sublimatedware/Drone-Detection-Robot-UoG-Captstone-2025-Legacy-/v8 test dataset/labels.jpg

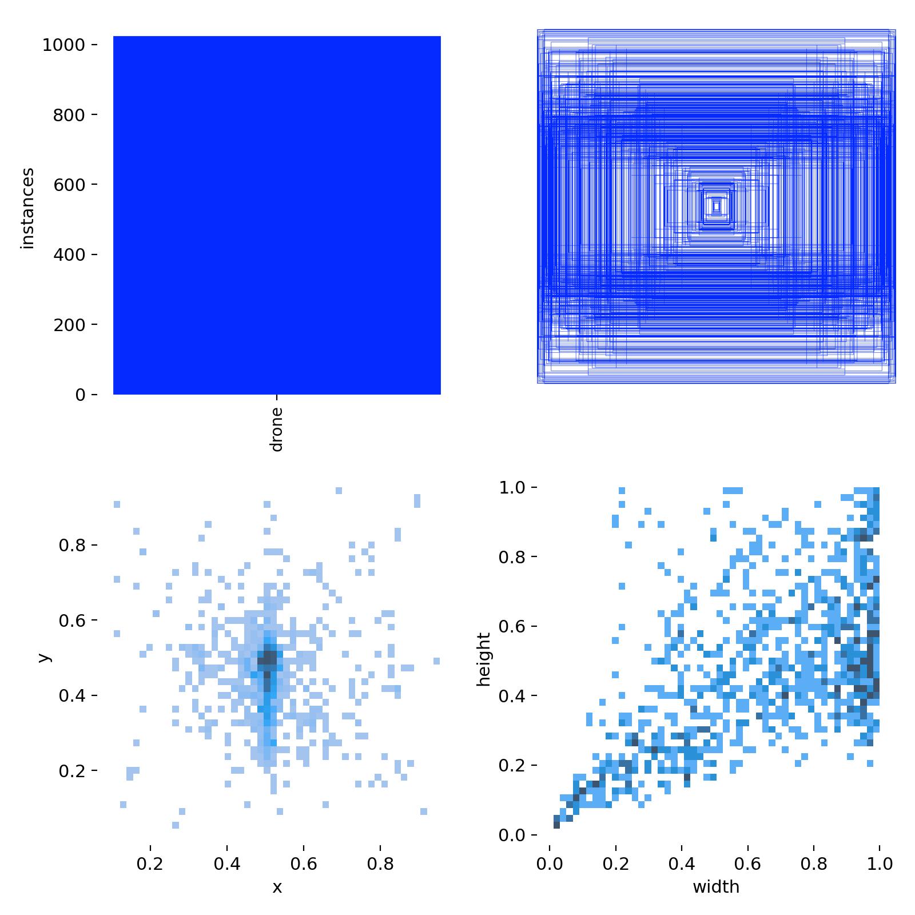
v8 test dataset/labels.jpg
