sublimatedware/Drone-Detection-Robot-UoG-Captstone-2025-Legacy-/README.md

# Drone-Detection-Robot-UoG-Captstone-2025-Legacy-
A global shutter camera attached to a 2 axis gimbal which automatically detects and tracks quadcoter style drones using YOLO computer vision
