sublimatedware/Drone-Detection-Robot-UoG-Captstone-2025-Legacy-/ENGG41x0_Drone_Tracker_Poster.pdf

## Jake Lamoureux | Laura Cao | Dominik Hoang | Kevin Pham

# Advanced Drone Tracking Camera System

Winter 2025

## Problem Statement

## Results

Confusion Matrix

## Objective

## Motor Controller

### - TB6600 Stepper

### Motor Controller

## 120 FPS Camera

### - Econ Systems

### See3CAM_24CUG

## 360°Camera Mount

### - Two-stepper motor arm

### design for precise Y- and

Z-axis movement.

## Microcontroller

### - Arduino Uno

## Faculty Advisor:

Hussein Abdullah, PhD, P.Eng.

## Background

As drones become more widely used in homes and businesses, the need for effective tracking solutions that address privacy,

### real-time processing, and environmental adaptability becomes

increasingly important. Many solutions are costly, inefficient,

### and fail to meet regulatory and safety standards. There is a

### clear need for an affordable, efficient, and privacy-conscious drone tracking system that integrates seamlessly into modern

security frameworks while ensuring safety and compliance.

- Develop an affordable drone tracking system that provides real-time, accurate tracking while ensuring privacy for consumers and businesses.
- Integrate responsive servo motor control for smooth, precise tracking and reduced safety risks in dynamic environments.
- Optimize for power efficiency to lower operational costs and extend runtime, making the solution accessible to both commercial and household users.
- Design a scalable, adaptable system functional in various environments and affordable drone models.
- Drone use has grown rapidly, especially in consumer markets for home security and personal use.
- As drones become more
widespread, privacy, safety, and effective tracking are growing concerns.
- While tracking systems have improved in accuracy, many still face challenges with real-time processing and adaptability.
- Existing solutions are often expensive and lack power
efficiency for extended use.

F1-Confidence Curve

- 137 Correct drone
detections (True
Positives)
- 29 Background
misclassified as drones
(False Positives)
- 14 Missed drones (False
Negatives)
- F1 is a combination of Recall and Precision
- Max. Performance is at
around 60% Confidence
- Higher = Strict (fewer
detections & false alarms)
- Lower = Lenient (more
detections & false positives)

## Design Solution

- The system integrates object detection technology for real-time tracking using visual processing.
- YOLOv8 was implemented to ensure high accuracy in dynamic environments.
- The design was tested under various lighting and movement conditions, balancing speed and accuracy.
- Servo motors control camera positioning, enabling smooth, responsive tracking with low latency.
- Feedback from drone operators and object detection experts refined the system’s performance and reliability.
- The final design achieves accurate and fast tracking while maintaining regulatory compliance.

## Sample Output

137 29

14

## Sample Dataset
