sublimatedware/Drone-Detection-Robot-UoG-Captstone-2025-Legacy-/Photos/20250327_173003.jpg

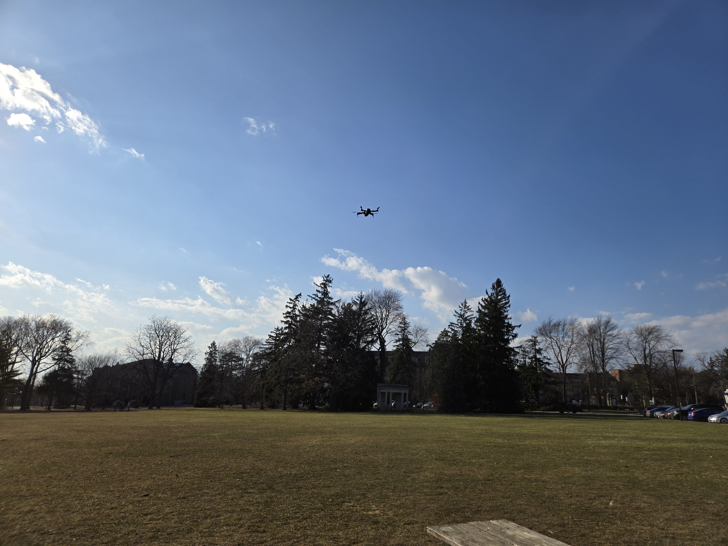
Photos/20250327_173003.jpg
