sublimatedware/Drone-Detection-Robot-UoG-Captstone-2025-Legacy-/Photos/20250327_173009.jpg

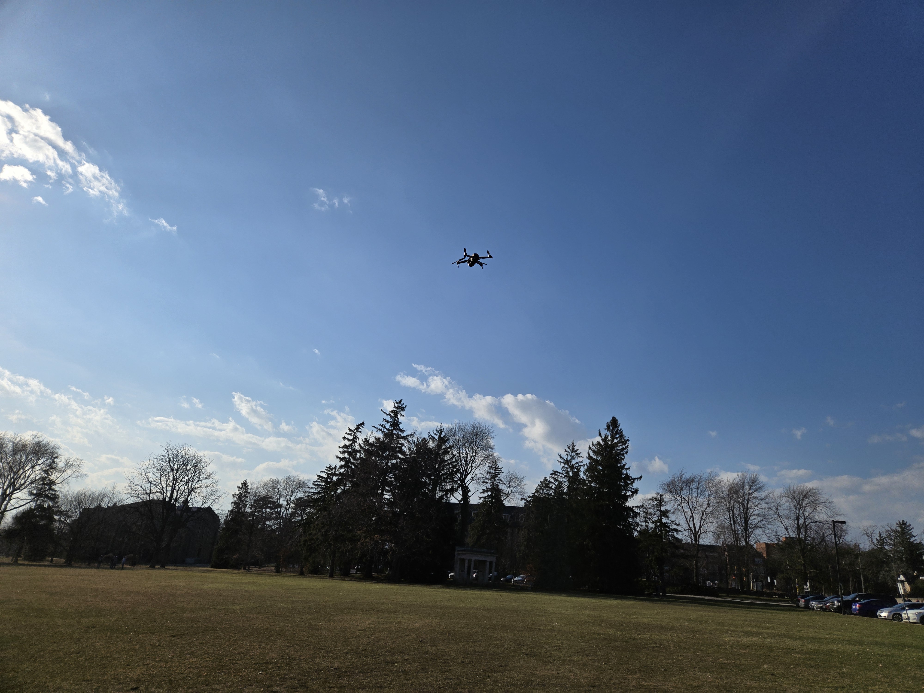
Photos/20250327_173009.jpg
