sublimatedware/Drone-Detection-Robot-UoG-Captstone-2025-Legacy-/hardware/drone robot bracket.SLDPRT

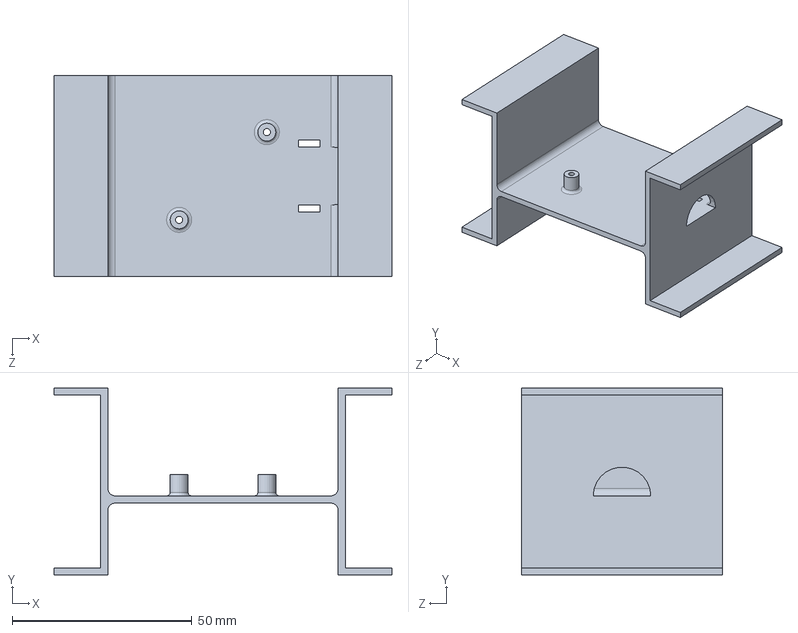
[picture p12: CAD file, 2026-03-03]
hardware/drone robot bracket.SLDPRT
94.0 x 52.0 x 56.0 mm
