sublimatedware/Drone-Detection-Robot-UoG-Captstone-2025-Legacy-/v8 test dataset/results.csv

epoch | time | train/box_loss | train/cls_loss | train/dfl_loss | metrics/precision(B) | metrics/recall(B) | metrics/mAP50(B) | metrics/mAP50-95(B) | val/box_loss | val/cls_loss | val/dfl_loss | lr/pg0 | lr/pg1 | lr/pg2
1 | 204.546 | 1.38193 | 2.69714 | 1.88157 | 0.77309 | 0.13544 | 0.46038 | 0.19096 | 1.77564 | 3.53019 | 2.25328 | 0.000655367 | 0.000655367 | 0.000655367
2 | 410.79 | 1.44968 | 2.15134 | 1.92487 | 0.46925 | 0.42743 | 0.37461 | 0.13164 | 2.10158 | 3.73565 | 3.11461 | 0.00119115 | 0.00119115 | 0.00119115
3 | 610.784 | 1.50241 | 1.88847 | 1.94473 | 0.35222 | 0.27368 | 0.27472 | 0.09028 | 2.24521 | 2.8034 | 2.57071 | 0.00159494 | 0.00159494 | 0.00159494
4 | 810.477 | 1.4616 | 1.65854 | 1.91873 | 0.63094 | 0.46358 | 0.52862 | 0.21979 | 2.12686 | 2.67231 | 2.63859 | 0.001406 | 0.001406 | 0.001406
5 | 1010.59 | 1.47131 | 1.49368 | 1.90304 | 0.66324 | 0.52173 | 0.55058 | 0.23464 | 1.82952 | 2.14501 | 2.22737 | 0.001208 | 0.001208 | 0.001208
6 | 1209.97 | 1.37651 | 1.2969 | 1.80959 | 0.81656 | 0.72185 | 0.75918 | 0.40788 | 1.66302 | 1.46841 | 1.98083 | 0.00101 | 0.00101 | 0.00101
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
