sublimatedware/Drone-Detection-Robot-UoG-Captstone-2025-Legacy-/v8 test dataset/confusion_matrix.png

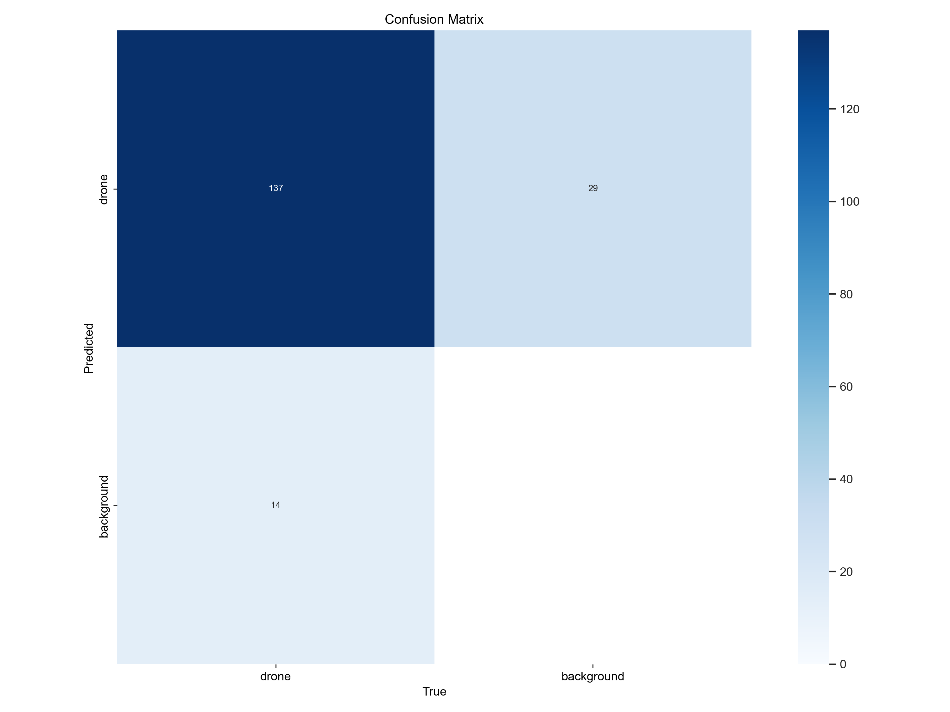
v8 test dataset/confusion_matrix.png
