sublimatedware/Drone-Detection-Robot-UoG-Captstone-2025-Legacy-/v8 test dataset/F1_curve.png

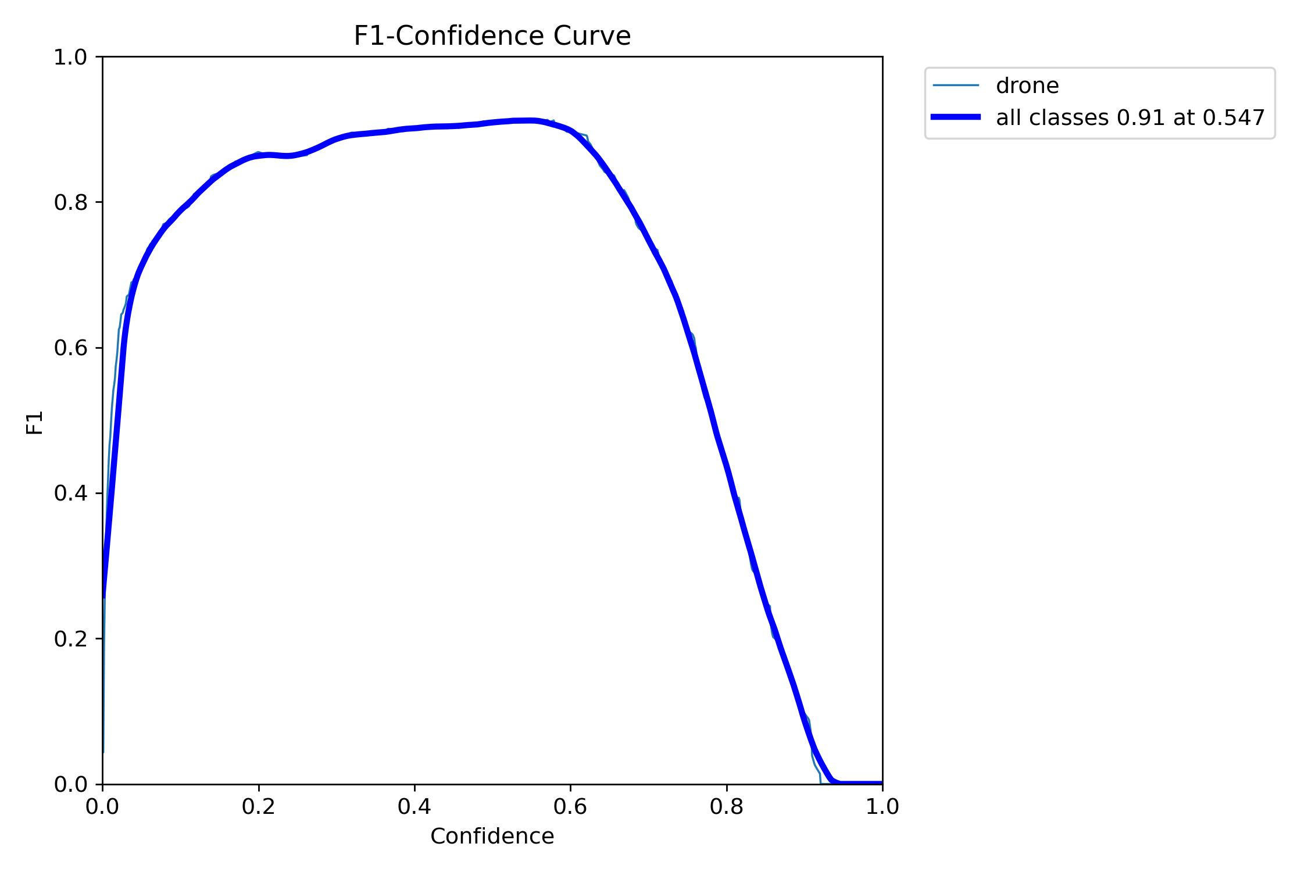
v8 test dataset/F1_curve.png
