sublimatedware/Drone-Detection-Robot-UoG-Captstone-2025-Legacy-/v8 test dataset/PR_curve.png

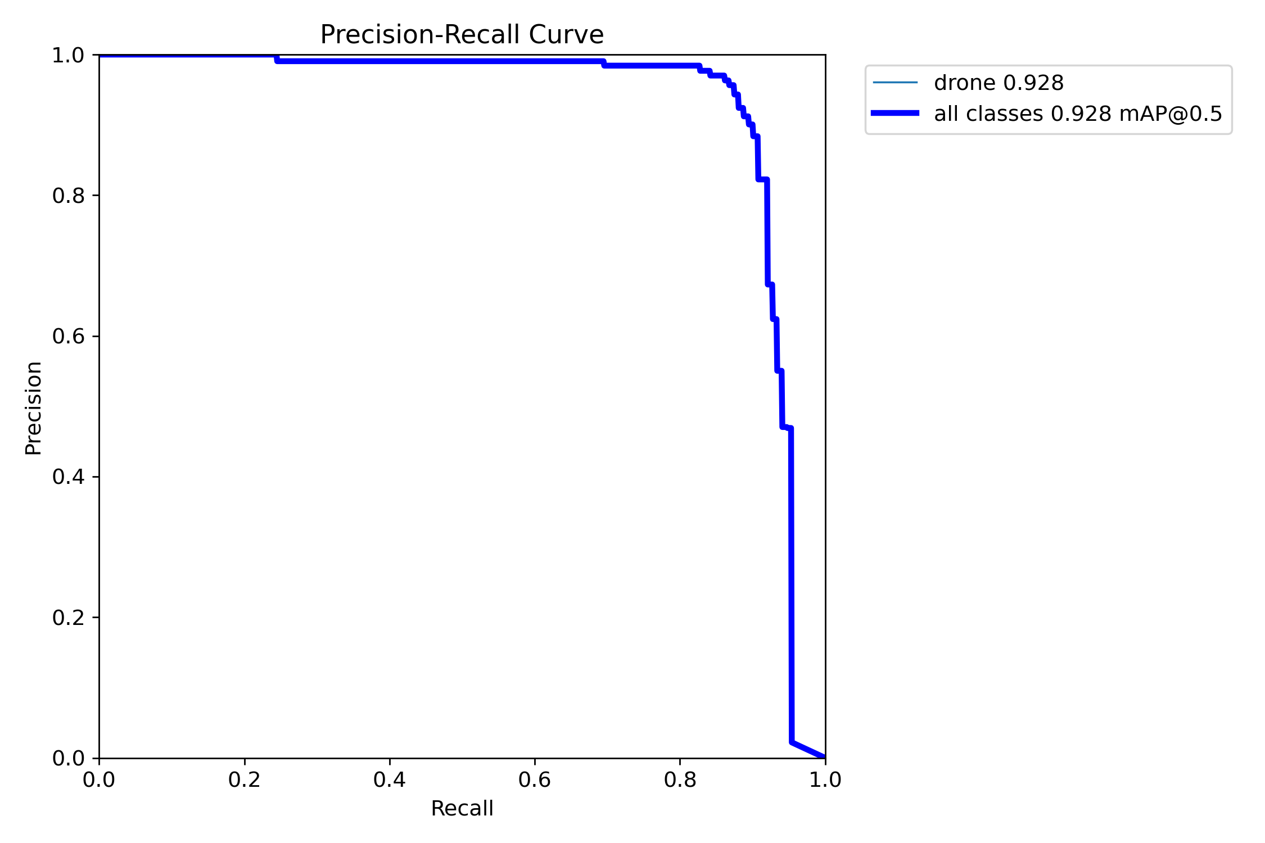
v8 test dataset/PR_curve.png
