sublimatedware/Drone-Detection-Robot-UoG-Captstone-2025-Legacy-/v8 test dataset/train_batch1.jpg

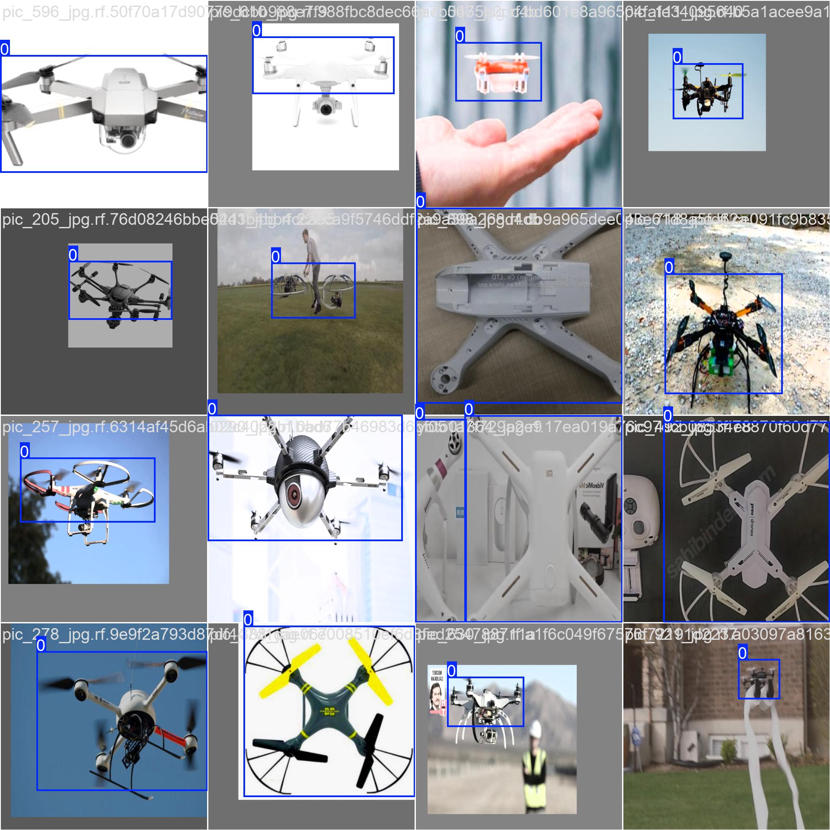
v8 test dataset/train_batch1.jpg
