sublimatedware/Drone-Detection-Robot-UoG-Captstone-2025-Legacy-/v8 test dataset/val_batch0_labels.jpg

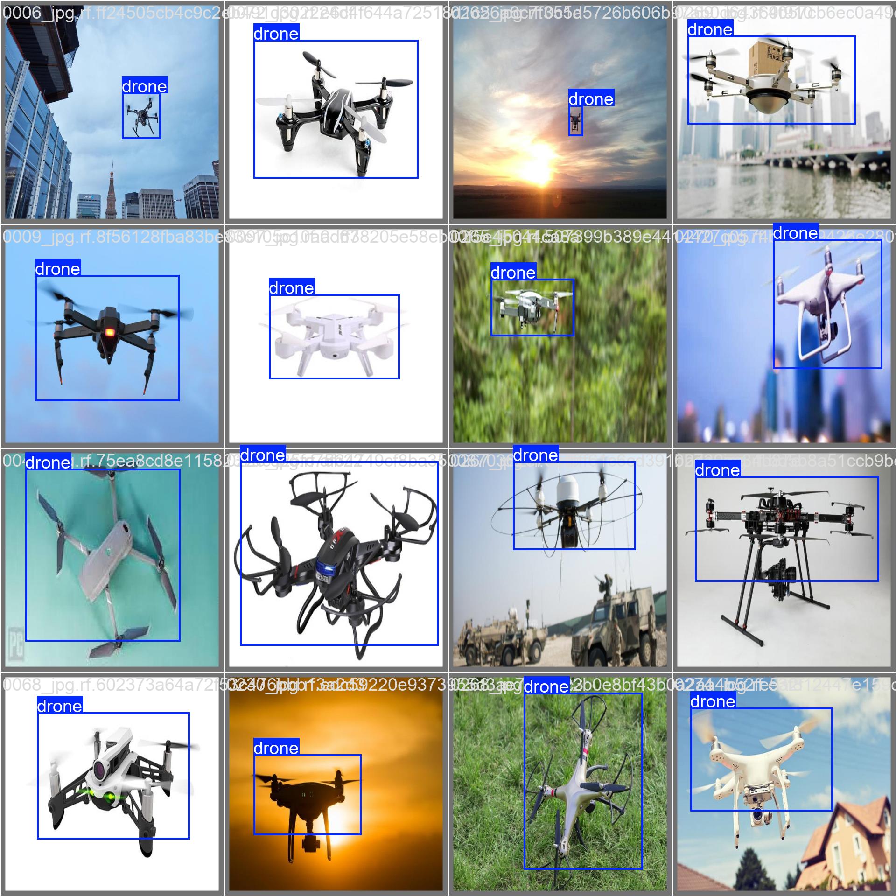
v8 test dataset/val_batch0_labels.jpg
