sublimatedware/Drone-Detection-Robot-UoG-Captstone-2025-Legacy-/hardware/Capstone Circuit/Capstone Circuit.kicad_sch

## KiCad design hardware/Capstone Circuit/Capstone Circuit.kicad_sch (2026-03-03)

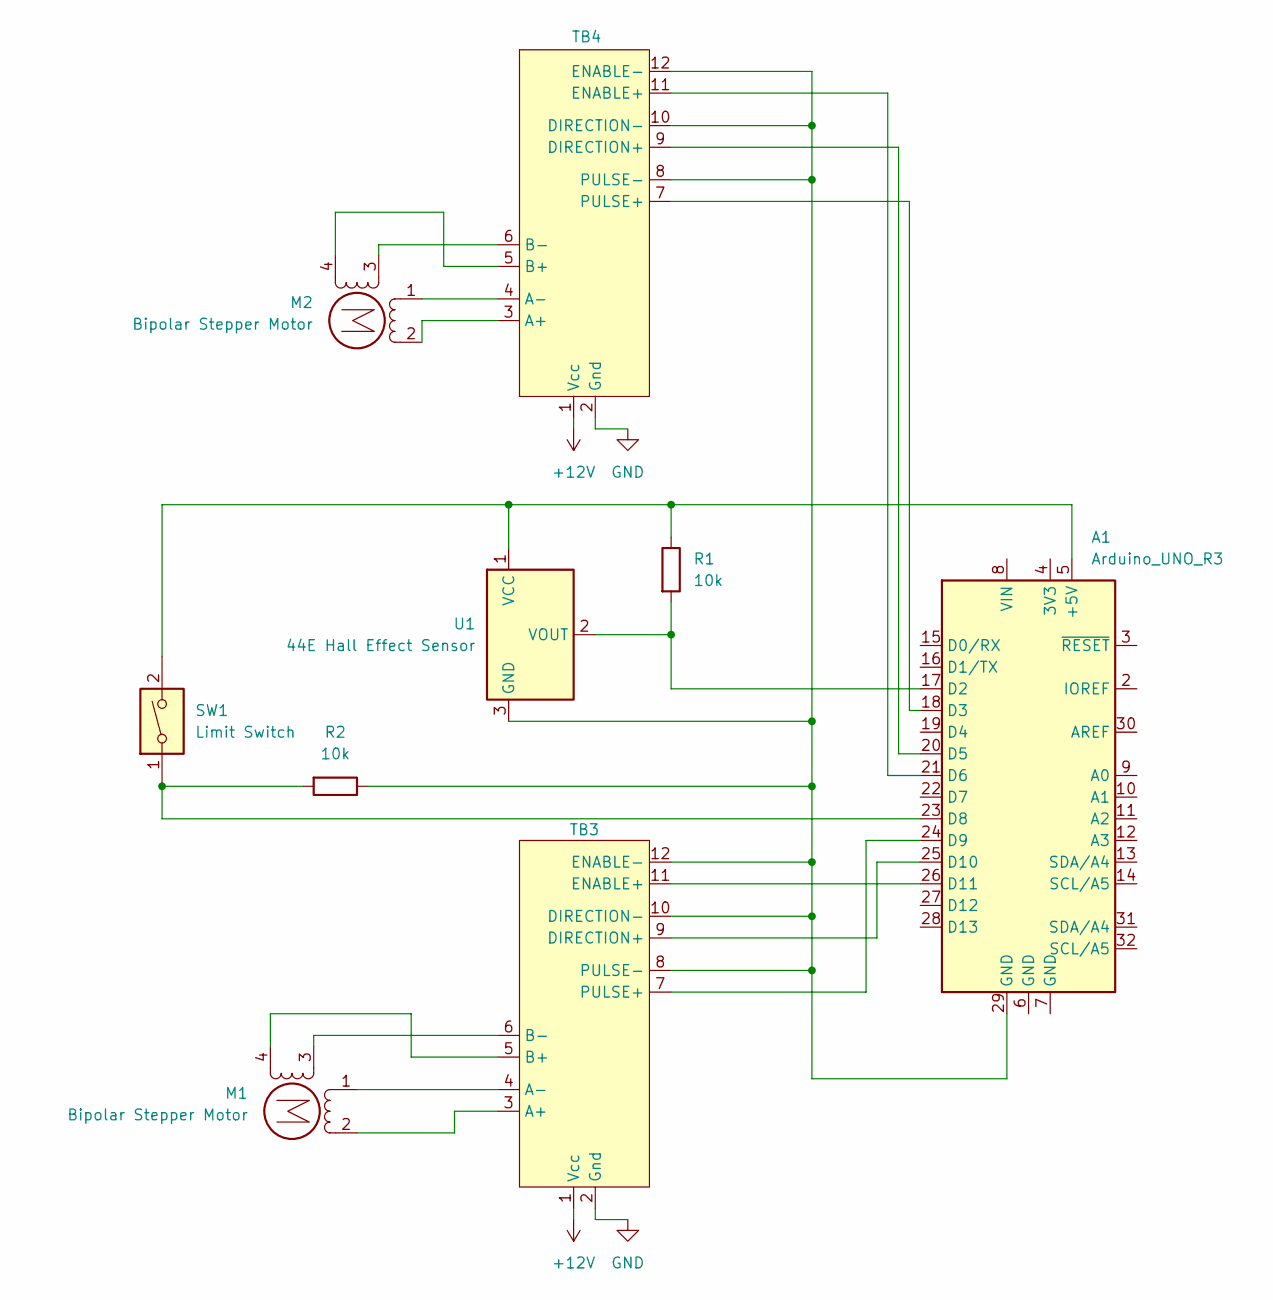
[picture p26: schematic Capstone Circuit.kicad_sch]

Parts:
A1: Arduino_UNO_R3
M1, M2: Bipolar Stepper Motor
R1, R2: 10k
SW1: Limit Switch
TB3, TB4: (no value)
U1: 44E Hall Effect Sensor; SOT-23W

Connections:
+12V: TB3.1 (Vcc), TB4.1 (Vcc)
GND: TB3.2 (Gnd), TB4.2 (Gnd)
unnamed: A1.5 (+5V), R1.1, SW1.2, U1.1 (VCC)
unnamed: A1.17 (D2), R1.2, U1.2 (VOUT)
unnamed: A1.18 (D3), TB4.7 (PULSE+)
unnamed: A1.20 (D5), TB4.9 (DIRECTION+)
unnamed: A1.21 (D6), TB4.11 (ENABLE+)
unnamed: A1.23 (D8), R2.2, SW1.1
unnamed: A1.24 (D9), TB3.7 (PULSE+)
unnamed: A1.25 (D10), TB3.9 (DIRECTION+)
unnamed: A1.26 (D11), TB3.11 (ENABLE+)
unnamed: A1.29 (GND), R2.1, TB3.8 (PULSE-), TB3.10 (DIRECTION-), TB3.12 (ENABLE-), TB4.8 (PULSE-), TB4.10 (DIRECTION-), TB4.12 (ENABLE-), U1.3 (GND)
unnamed: M1.1, TB3.4 (A-)
unnamed: M1.2 (-), TB3.3 (A+)
unnamed: M1.3, TB3.6 (B-)
unnamed: M1.4, TB3.5 (B+)
unnamed: M2.1, TB4.4 (A-)
unnamed: M2.2 (-), TB4.3 (A+)
unnamed: M2.3, TB4.6 (B-)
unnamed: M2.4, TB4.5 (B+)
