sublimatedware/Drone-Detection-Robot-UoG-Captstone-2025-Legacy-/Firmware/Drone_Detection_Robot mar 10/telemetrixtest.py

import sys
import time

from telemetrix import telemetrix

"""
Monitor a digital input pin
"""

"""
Setup a pin for digital input and monitor its changes
"""

# Setup a pin for analog input and monitor its changes
DIGITAL_PIN = 8  # arduino pin number

# Callback data indices
CB_PIN_MODE = 0
CB_PIN = 1
CB_VALUE = 2
CB_TIME = 3


def the_callback(data):
    """
    A callback function to report data changes.
    This will print the pin number, its reported value and
    the date and time when the change occurred

    :param data: [pin, current reported value, pin_mode, timestamp]
    """
    date = time.strftime('%Y-%m-%d %H:%M:%S', time.localtime(data[CB_TIME]))
    print(f'Pin Mode: {data[CB_PIN_MODE]} Pin: {data[CB_PIN]} Value: {data[CB_VALUE]} Time Stamp: {date}')


def digital_in(my_board, pin):
    """
     This function establishes the pin as a
     digital input. Any changes on this pin will
     be reported through the call back function.

     :param my_board: a pymata4 instance
     :param pin: Arduino pin number
     """

    # set the pin mode
    my_board.set_pin_mode_digital_input(pin, callback=the_callback)

    print('Enter Control-C to quit.')
    # my_board.enable_digital_reporting(12)
    try:
        while True:
            time.sleep(.0001)
    except KeyboardInterrupt:
        board.shutdown()
        sys.exit(0)


board = telemetrix.Telemetrix()

try:
    digital_in(board, DIGITAL_PIN)
except KeyboardInterrupt:
    board.shutdown()
    sys.exit(0)
