sublimatedware/Drone-Detection-Robot-UoG-Captstone-2025-Legacy-/(notices)

Notices in the files:
Firmware/DDR mar 16/DDR_Telemetrix_Server_ID1/DDR_Telemetrix_Server_ID1.ino:
modify it under the terms of the GNU AFFERO GENERAL PUBLIC LICENSE
