sublimatedware/Drone-Detection-Robot-UoG-Captstone-2025-Legacy-/Photos/20250331_140019.jpg

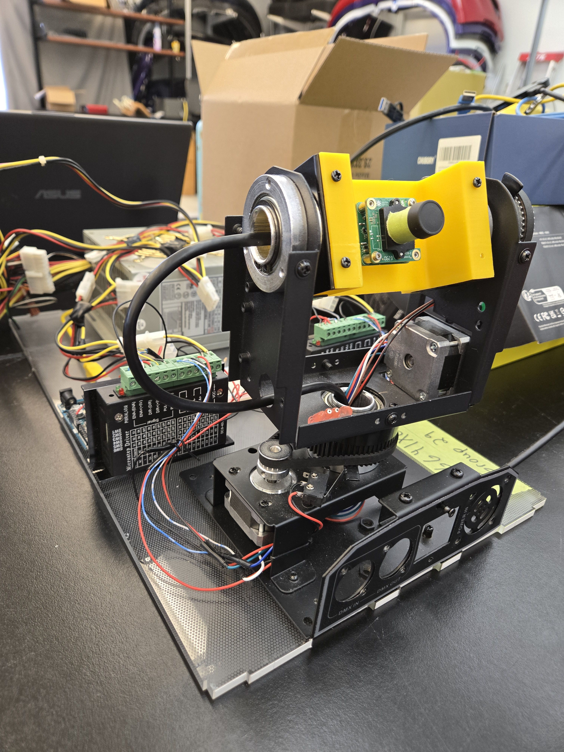
Photos/20250331_140019.jpg
